AlfredoSystems/Spin-Hardware/Spin-Eggman/Spin-Eggman.kicad_pcb

## KiCad design Spin-Eggman/Spin-Eggman.kicad_pcb (2022-05-31)

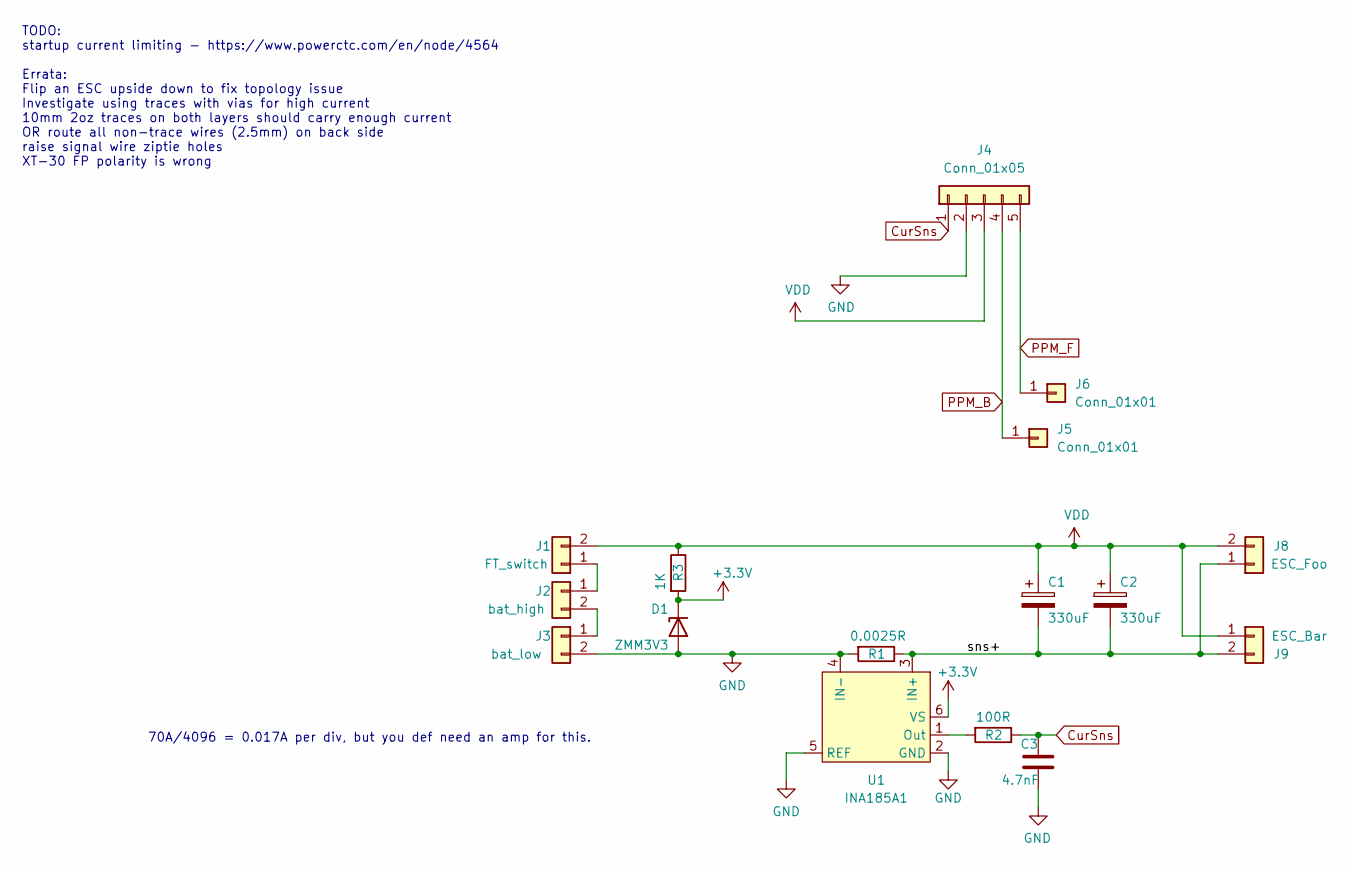
[picture p4: schematic Spin-Eggman.kicad_sch]

Parts:
C1, C2: 330uF; TGD_lowESR_cap
C3: 4.7nF; C_0603_1608Metric; LCSC C53987
D1: ZMM3V3; D_MiniMELF; LCSC C8056
J1: FT_switch; FT_Switch_Vertical
J2: bat_high; TGD_2P_BatHoles
J3: bat_low; TGD_2P_BatHoles
J4: Conn_01x05; JST_EH_B5B-EH-A_1x05_P2.50mm_Vertical
J5, J6: Conn_01x01; TGD-antenna-THT
J8: ESC_Foo; TGD_ESC_SigPads
J9: ESC_Bar; TGD_ESC_SigPads
R1: 0.0025R; R_2512_6332Metric_Pad1.40x3.35mm_HandSolder; LCSC C2692059
R2: 100R; R_0603_1608Metric; LCSC C22775
R3: 1K; R_0603_1608Metric; LCSC C21190
U1: INA185A1; SOT-563

Connections:
+3V3: D1.1 (K), R3.2, U1.6 (VS)
/sns+: C1.2, C2.2, J8.1, J9.2, R1.1, U1.3 (IN+)
CurSns: C3.2, J4.1, R2.1
GND: C3.1, D1.2 (A), J3.2, J4.2, R1.2, U1.2 (GND), U1.4 (IN-), U1.5 (REF)
unnamed: J1.1, J2.1
unnamed: J2.2, J3.1
unnamed: R2.2, U1.1 (Out)
PPM_B: J4.4, J5.1
PPM_F: J4.5, J6.1
VDD: C1.1, C2.1, J1.2, J4.3, J8.2, J9.1, R3.1

Notes on the sheet:
70A/4096 = 0.017A per div, but you def need an amp for this.
TODO: startup current limiting - https://www.powerctc.com/en/node/4564 Errata: Flip an ESC upside down to fix topology issue Investigate using traces with vias for high current 10mm 2oz traces on both layers should carry enough current OR route all non-trace wires (2.5mm) on back side raise signal 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

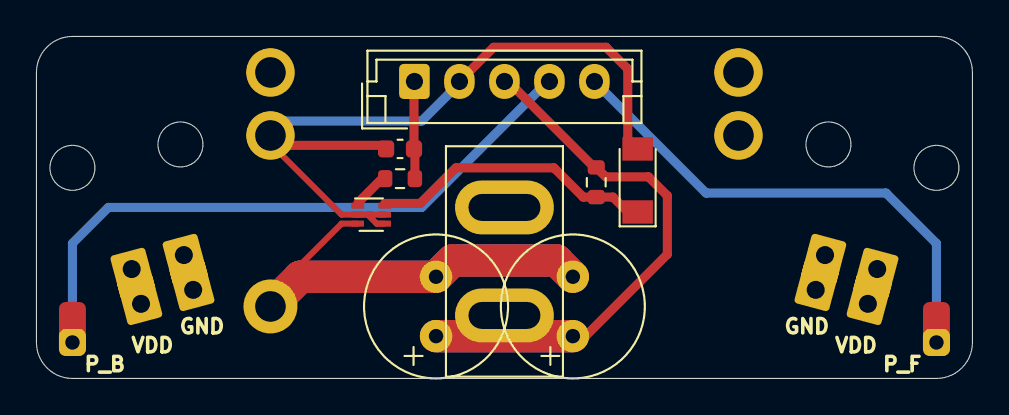
[picture p5: board Spin-Eggman.kicad_pcb from above]

Board: 2 copper layers, 52.0 x 19.0 mm, 16 parts (1 on the bottom side), 10 nets.
