AlfredoSystems/Spin-Hardware/Spin-Sonic/Spin-Sonic.kicad_pcb

## KiCad design Spin-Sonic/Spin-Sonic.kicad_pcb (2022-10-21)

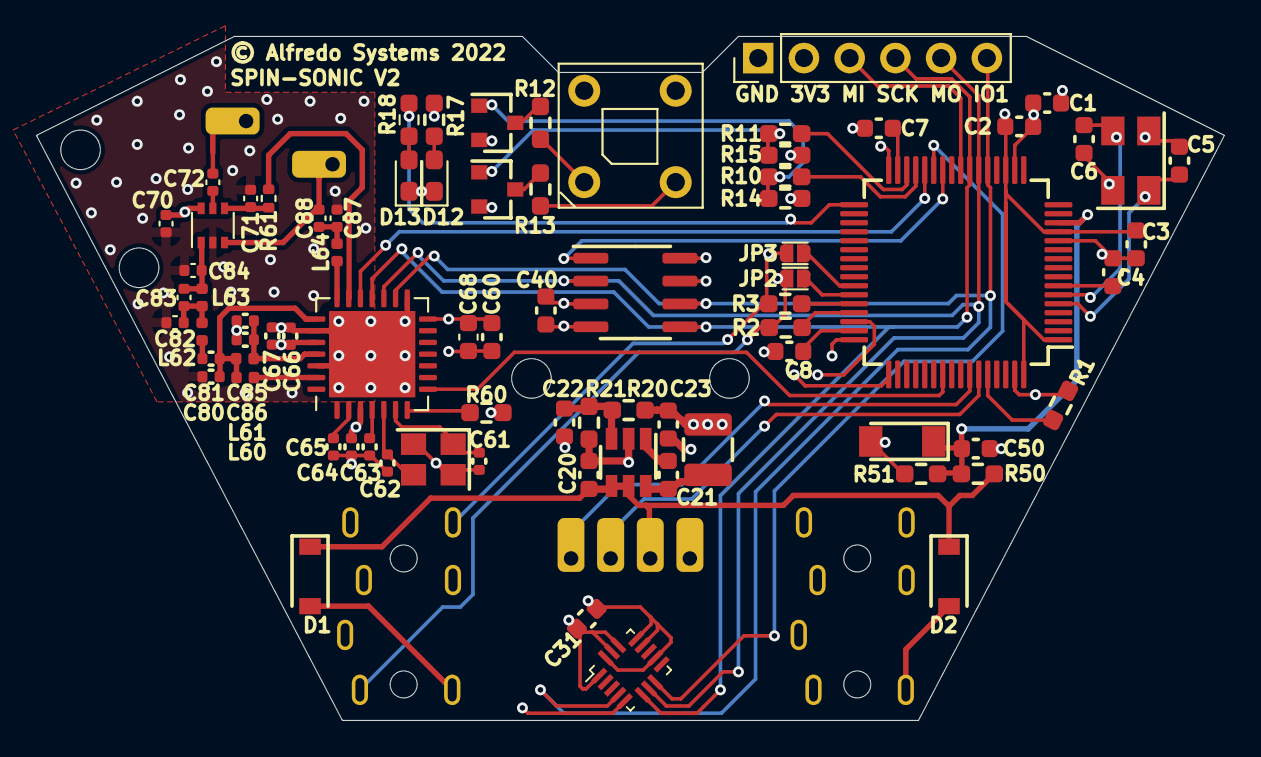
[picture p6: board Spin-Sonic.kicad_pcb from above]

Board: 4 copper layers, 66.0 x 38.0 mm, 86 parts (0 on the bottom side), 62 nets.

Parts:
C1, C7, C8, C20, C60: 2.2uF; C_0603_1608Metric
C2, C3, C4, C21, C31, C40, C50, C68: 100nF; C_0603_1608Metric
C5, C6: 15pF; C_0603_1608Metric
C22: 22pF; C_0603_1608Metric
C23: 22uF; C_0603_1608Metric
C61, C62: 15pF; C_0402_1005Metric
C63, C64, C65, C67, C85: 100nF; C_0402_1005Metric
C66, C72, C86, C88: 47pF; C_0402_1005Metric
C70, C71: 1nF; C_0402_1005Metric
C80, C82: 8.2pF; C_0402_1005Metric
C81: 22pF; C_0402_1005Metric
C83: 1.5pF; C_0402_1005Metric
C84, C87: 3.3pF; C_0402_1005Metric
D1, D2: B5819W; D_SOD-123
D10: R50RB2-F-0160
D12: LED_3V3; LED_0603_1608Metric_Pad1.05x0.95mm_HandSolder
D13: LED_MISC; LED_0603_1608Metric_Pad1.05x0.95mm_HandSolder
D50: ZMM3V3; D_MiniMELF
J1, J2: G-Switch-ST-0322; G-Switch-ST-TRRS
J4, J5, J6, J7: Conn_01x01; TGD-antenna-THT
J8: Conn_01x06; PinHeader_1x06_P2.54mm_Vertical
J64, J65: Conn_01x01_Female; TGD-antenna-THT
JP2, JP3: SolderJumper_2_Open; TGD_SolderJumper
L20: 4.7uH; L_1210_3225Metric
L60: 2.2nH; L_0402_1005Metric
L61: 33nH; L_0402_1005Metric
L62: 5.6nH; L_0402_1005Metric
L63: 4.7nH; L_0402_1005Metric
L64: 10nH; L_0402_1005Metric
Q11, Q12: AO3401A; SOT-23
R1, R14, R15, R20, R60: 10K; R_0603_1608Metric_Pad0.98x0.95mm_HandSolder
R2, R3, R13: 22R; R_0603_1608Metric_Pad0.98x0.95mm_HandSolder
R10, R11, R17, R18: 1K; R_0603_1608Metric_Pad0.98x0.95mm_HandSolder
R12: 10R; R_0603_1608Metric_Pad0.98x0.95mm_HandSolder
R21, R51: 2K2; R_0603_1608Metric_Pad0.98x0.95mm_HandSolder
R50: 15K; R_0603_1608Metric_Pad0.98x0.95mm_HandSolder
R61: 1K; R_0402_1005Metric
U1: STM32F405RGTx; LQFP-64_10x10mm_P0.5mm
U2: Crystal_GND24; Crystal_SMD_5032-4Pin_5.0x3.2mm
U20: SY8253ADC; TSOT-23-6
U30: H3LIS331DL; TGD-TFLGA-16_3x3mm
U40: LE25U40CMD; SOIC-8_3.9x4.9mm_P1.27mm
U60: SX1276; TGD-QFN-28-1EP_6x6mm_P0.65mm_EP4.8x4.8mm
U61: Crystal_GND24; Crystal_SMD_3225-4Pin_3.2x2.5mm
U62: PE4259; SOT-363_SC-70-6

Connections:
+3V3: C1.1, C2.1, C3.1, C22.1, C23.1, C31.1, C40.1, C60.1, C64.1, C66.1, C67.1, C68.1, C70.2, J8.2, L20.2, Q11.2 (S), Q12.2 (S), R14.1, R15.1, R17.1, R20.1, R60.1, U1.1 (VBAT), U1.13 (VDDA), U1.19 (VDD), U1.32 (VDD), U1.48 (VDD), U1.64 (VDD), U30.1 (VDDIO), U30.14 (VDD), U30.15 (VDDR), U40.3 (WP), U40.7 (HOLD), U40.8 (VDD), U60.3 (VBAT_ANA_1), U60.14 (VBAT_DIG_3), U60.24 (VBAT_RF_2), U62.6 (VDD)
/sx1276/Antenna: C72.2, J65.1
/sx1276/RST: R60.2, U60.7 (NRESET)
CS_A: U1.27 (PB1), U30.8 (CS)
CS_L: U1.28 (PB2), U60.19 (~CS)
CS_M: U1.26 (PB0), U40.1 (CS)
GND: C1.2, C2.2, C3.2, C4.1, C5.1, C6.1, C7.2, C8.2, C20.2, C23.2, C31.2, C40.2, C50.2, C60.2, C61.1, C62.1, C63.2, C64.2, C65.2, C66.2, C67.2, C68.2, C70.1, C71.1, C80.2, C82.2, C84.2, C85.2, C86.2, C87.2, D10.1 (NC), D10.2 (COM_CA), D12.1 (K), D13.1 (K), D50.2 (A), J1.4 (Audio_L), J2.4 (Audio_L), J7.1, J8.1, R1.1, R21.2, R51.2, U1.12 (VSSA), U1.18 (VSS), U1.63 (VSS), U2.2, U2.4, U20.2 (GND), U30.5 (GND), U30.10 (GNDR), U30.12 (GND), U30.13 (GND), U30.16 (GND), U40.4 (VSS), U60.15 (GND), U60.23 (GND), U60.26 (GND), U60.29 (GND_PAD), U61.2, U61.4, U62.2 (GND)
GPIO1: J8.3, U1.24 (PC4)
INT_L: U1.55 (PB3), U60.8 (DIO0)
LED_BLUE: R10.1, U1.29 (PB10)
LED_MISC: R18.1, U1.33 (PB12)
LED_RED: R11.1, U1.30 (PB11)
unnamed: C4.2, U1.7 (NRST)
unnamed: C5.2, U1.5 (PH0), U2.1
unnamed: C6.2, U1.6 (PH1), U2.3
unnamed: C7.1, U1.31 (VCAP_1)
unnamed: C8.1, U1.47 (VCAP_2)
unnamed: C21.1, U20.1 (BS)
unnamed: C21.2, L20.1, U20.6 (LX)
unnamed: C22.2, R20.2, R21.1, U20.3 (FB)
unnamed: C61.2, U60.6 (XTB), U61.1
unnamed: C62.2, U60.5 (XTA), U61.3
unnamed: C63.1, U60.4 (VR_DIG)
unnamed: C65.1, U60.2 (VR_ANA)
unnamed: C71.2, R61.1, U62.4 (CTRL)
unnamed: C72.1, U62.5 (RFC)
unnamed: C81.2, L62.1
unnamed: C82.1, C83.1, L62.2, L63.1
unnamed: C87.1, C88.2, L64.2
unnamed: D1.2 (A), J1.1 (GND)
unnamed: D2.2 (A), J2.1 (GND)
unnamed: D10.3 (BLUE_AN), R12.2
unnamed: D10.4 (RED_AN), R13.2
unnamed: D12.2 (A), R17.2
unnamed: D13.2 (A), R18.2
unnamed: J1.2 (MIC), JP2.1 (A), R2.2
unnamed: J1.3 (Audio_R), JP3.1 (A), R3.1
unnamed: Q11.1 (G), R10.2, R14.2
unnamed: Q11.3 (D), R12.1
unnamed: Q12.1 (G), R11.2, R15.2
unnamed: Q12.3 (D), R13.1
unnamed: R1.2, U1.60 (BOOT0)
PA_BOOST: L60.1, U60.27 (PA_BOOST)
PPM_B: J5.1, U1.59 (PB7)
PPM_F: J4.1, U1.58 (PB6)
P_MISO: J8.5, U1.22 (PA6), U30.7 (MISO), U40.2 (SO/SIO1), U60.17 (MISO)
P_MOSI: J8.4, U1.23 (PA7), U30.6 (MOSI), U40.5 (SI/SIO0), U60.18 (MOSI)
P_SCK: J8.6, U1.21 (PA5), U30.4 (SCK), U40.6 (SCK), U60.16 (SCK)
RF1: C83.2, C84.1, L63.2, U62.1 (RF1)
RF2: C88.1, J64.1, U62.3 (RF2)
RFI_HF: L64.1, U60.21 (RFI_HF)
RFO_HF: C80.1, C81.1, L60.2, L61.1, U60.22 (RFO_HF)
RF_MOD: R61.2, U60.20 (RF_MOD)
SNS_VIN: C50.1, D50.1 (K), R50.2, R51.1, U1.14 (PA0)
SWD_CLK: J2.3 (Audio_R), U1.49 (PA14)
SWD_DIO: J2.2 (MIC), U1.46 (PA13)
USB_DM: R3.2, U1.44 (PA11)
USB_DP: R2.1, U1.45 (PA12)
USB_RX: JP2.2 (B), U1.43 (PA10)
USB_TX: JP3.2 (B), U1.42 (PA9)
VDD: C20.1, D1.1 (K), D2.1 (K), J6.1, R50.1, U20.4 (EN), U20.5 (IN)
VR_PA: C85.1, C86.1, L61.2, U60.25 (VR_PA)
