AlfredoSystems/Spin-Hardware/(commit log)

2022-01-02 Initial revision, used at NHRL Nov21
    [TGD.kicad_pcb, TGD.sch, TGD_LED.kicad_pcb, TGD_LED.sch, sx1276.sch, tiny6.sch]
2022-01-02 added pull-up resistors for LED FETS
2022-01-08 Schematic and Layout first draft completed, need to route next
    [TGD.kicad_pcb, TGD.kicad_sch, TGD.sch, sx1276.kicad_sch, sx1276.sch, tiny6.sch]
2022-01-13 last V2 version before switching to separate power and control boards
    [TGD-B_Cu.gbl, TGD-B_Mask.gbs, TGD-B_Silkscreen.gbo, TGD-Edge_Cuts.gm1, TGD-F_Cu.gtl, TGD-F_Mask.gts, TGD-F_Paste.gtp, TGD-F_Silkscreen.gto]
2022-01-16 Version of both power and control boards ordered on 1-15-21
    [TGD-B_Cu.gbl, TGD-B_Mask.gbs, TGD-B_Silkscreen.gbo, TGD-Edge_Cuts.gm1, TGD-F_Cu.gtl, TGD-F_Mask.gts, TGD-F_Paste.gtp, TGD-F_Silkscreen.gto]
2022-01-24 DSP DAC circuit and FO card todo notes
    [spin-tgd-power.kicad_pcb, spin-tgd-power.kicad_sch]
2022-05-08 Moved to new library system
    [spin-tgd-control.kicad_sch, spin-tgd-power.kicad_sch]
2022-05-12 created pdfs for V2 schematics
    [spin-tgd-control.kicad_sch]
2022-05-31 Eggman V2 ordered gerbers
    [spin-tgd-control.kicad_sch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]
2022-10-20 file cleanup
    [spin-eggman.kicad_pcb, spin-eggman.kicad_sch, spin-sonic.kicad_pcb, spin-sonic.kicad_sch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]
2022-10-21 added PCB image
2022-10-21 added image folder and Spin-Sonic PDF
    [spin-eggman.kicad_sch, spin-sonic.kicad_pcb, spin-sonic.kicad_sch]
2022-10-21 removed project files
    [spin-eggman.kicad_pcb, spin-eggman.kicad_sch, spin-sonic.kicad_pcb, spin-sonic.kicad_sch, sx1276.kicad_sch]
2022-10-21 updated schematic descriptions
    [Spin-Eggman.kicad_pcb, Spin-Eggman.kicad_sch, Spin-Sonic.kicad_pcb, Spin-Sonic.kicad_sch, sx1276.kicad_sch]
