AlfredoSystems/Spin-Hardware/(notices)

Notices in the files:
Spin-Sonic/Spin-Sonic.kicad_pcb:
© Alfredo Systems 2022
Spin-Eggman/Spin-Eggman.kicad_pcb:
© Jacob Williams 2022
